gvp-study/reaction-wheel-pendulum/code/esc1_balance/closed_loop_fit.png

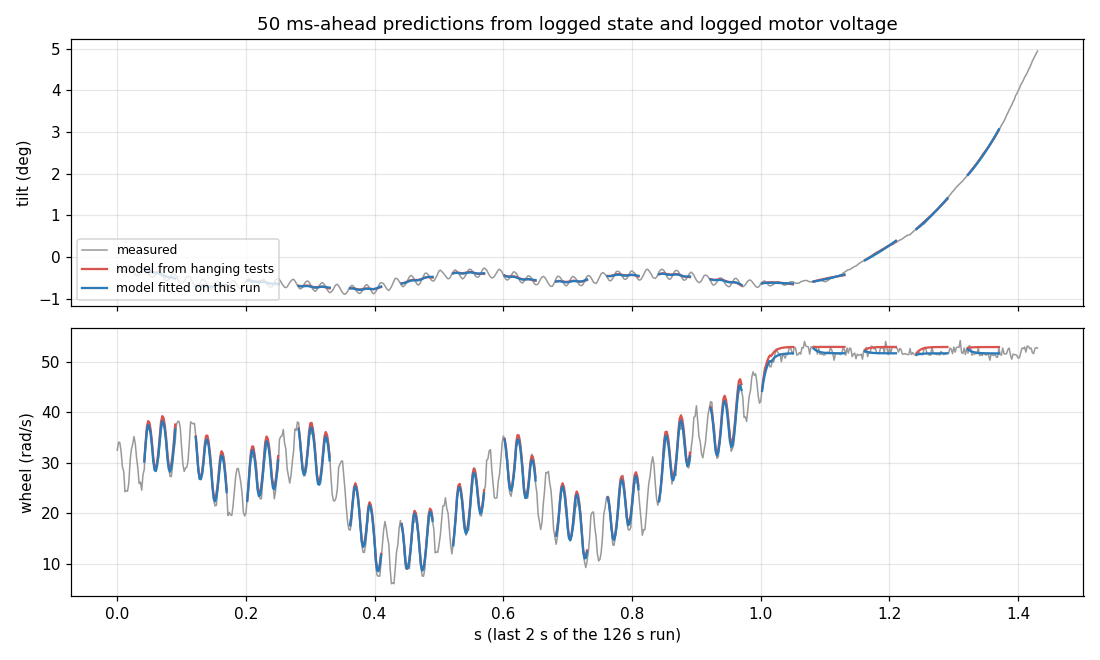
code/esc1_balance/closed_loop_fit.png
