gvp-study/reaction-wheel-pendulum/code/esc1_balance/swingup_sim.png

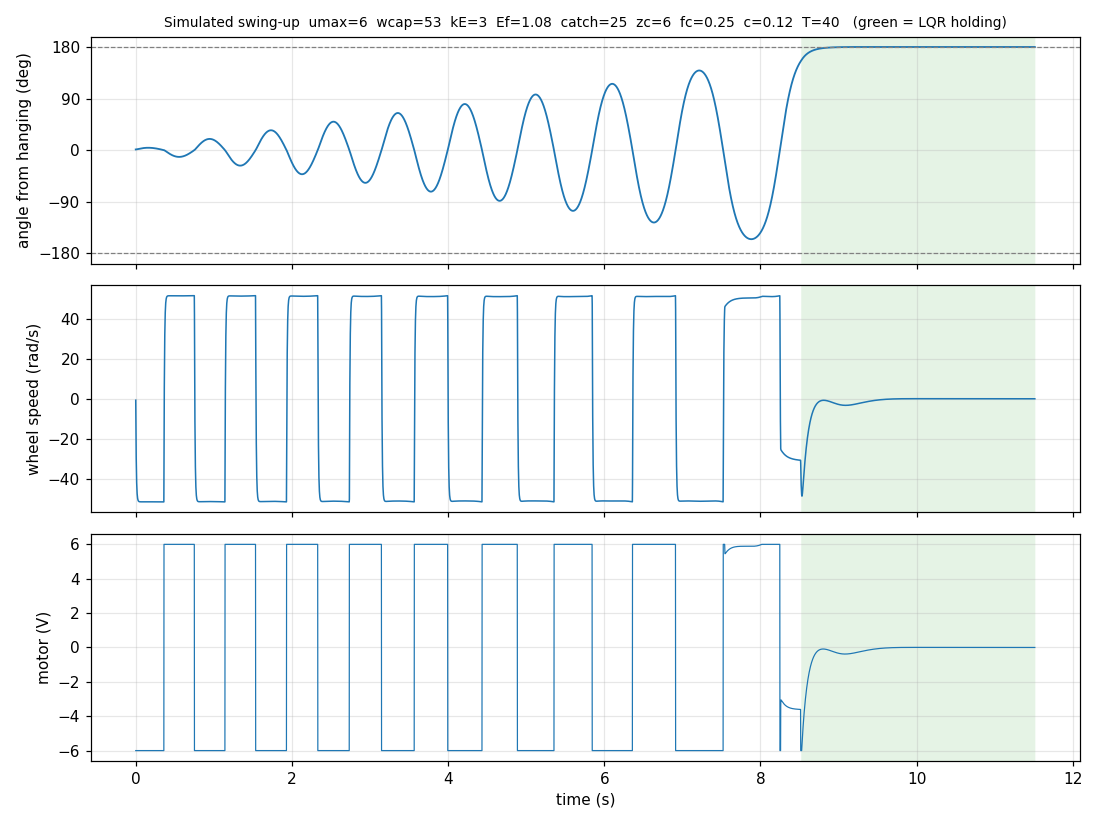
code/esc1_balance/swingup_sim.png
