gvp-study/reaction-wheel-pendulum/cad/pivot_shim.stl

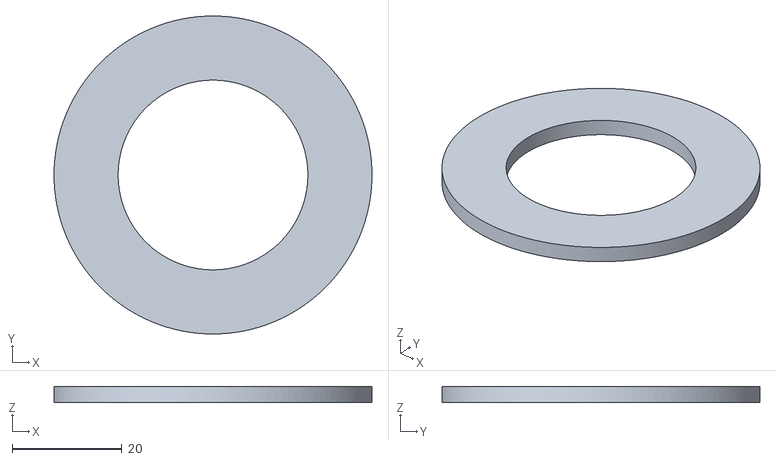
[picture p27: CAD file, 2026-11-08]
cad/pivot_shim.stl
58.0 x 58.0 x 3.00
