gvp-study/reaction-wheel-pendulum/cad/esc_box_lid.stl

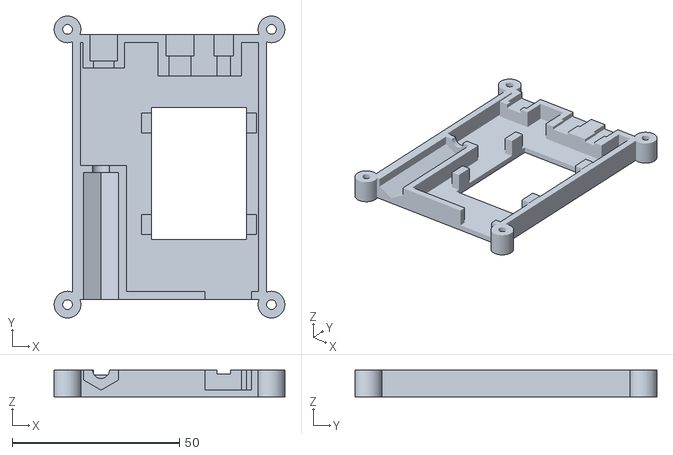
[picture p28: CAD file, 2026-11-08]
cad/esc_box_lid.stl
68.9 x 90.2 x 8.00
