gvp-study/reaction-wheel-pendulum/cad/stop_arch_left.stl

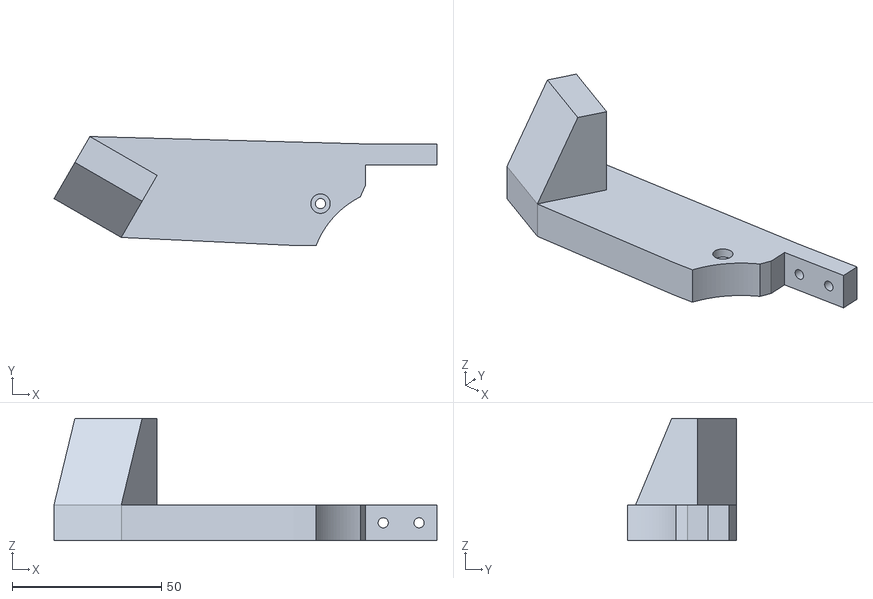
[picture p29: CAD file, 2026-11-08]
cad/stop_arch_left.stl
128.2 x 36.5 x 41.0
