gvp-study/reaction-wheel-pendulum/cad/pivot_block.stl

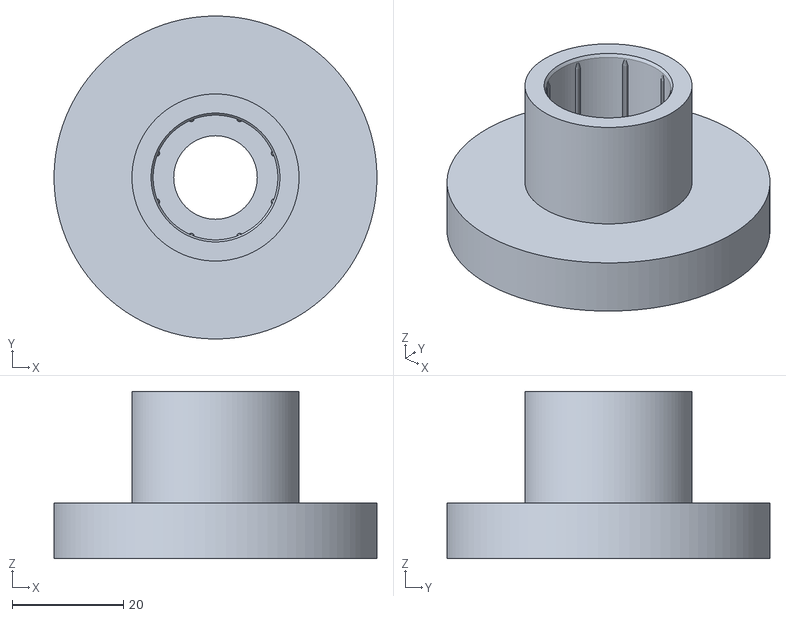
[picture p30: CAD file, 2026-11-08]
cad/pivot_block.stl
58.0 x 58.0 x 30.0
