gvp-study/reaction-wheel-pendulum/cad/wheel_adapter.stl

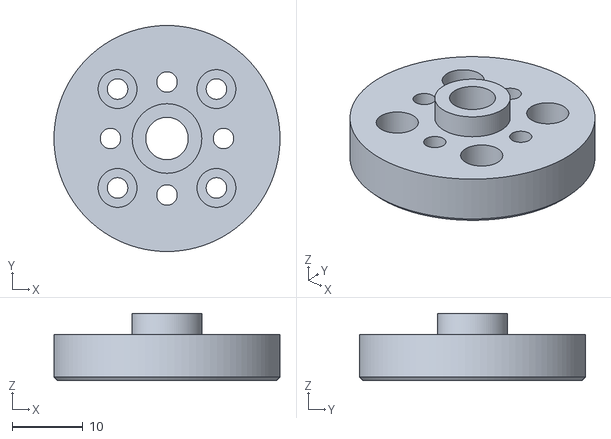
[picture p31: CAD file, 2026-11-08]
cad/wheel_adapter.stl
32.0 x 32.0 x 9.50
