gvp-study/reaction-wheel-pendulum/cad/pivot_spacer.stl

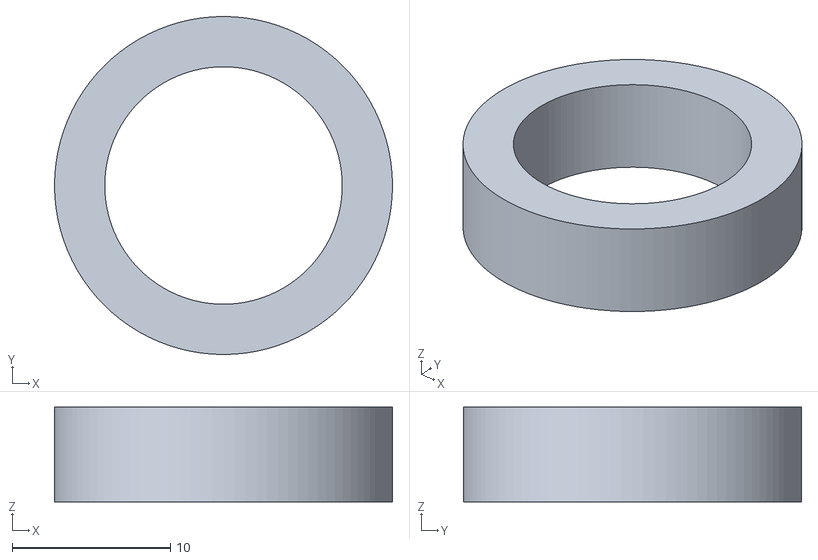
[picture p32: CAD file, 2026-11-08]
cad/pivot_spacer.stl
21.4 x 21.4 x 6.00
