gvp-study/reaction-wheel-pendulum/(list of files, cad)

Other CAD files:
cad/stop_arch_right.stl
