gvp-study/reaction-wheel-pendulum/(commit log)

2026-11-08 Reaction-wheel inverted pendulum: hardware, sysid, LQR, 126 s balance
    [esc_box.scad, esc_box_base.stl, esc_box_lid.stl, motor_mount.scad, pendulum_assembly.scad, pendulum_bar.scad, pivot_block.scad, pivot_block.stl]
2026-11-11 v4.1 swing-up: error-frame check, supply-voltage aware; swing-up simulators; logs
    [balance.csv]
